wmhunter96/Buka/docs/faces.md

# Face gallery

Every kaomoji face, rendered from the same generator data the firmware uses (each is a 3-second, 30-frame loop). Turn them on with Config / `POST /settings` `{"eyes_style":"kaomoji"}` ([api.md](api.md#kaomoji-eyes)). Faces with no trigger are in the library but not used by any animation yet.

| Face | Preview | Shown for |
| --- | --- | --- |
| Idle | Kaomoji idle | idle (`none`), sleep-open |
| Happy | Kaomoji happy | `welcome`, `talking` |
| Laugh | Kaomoji laugh | not used yet |
| Wink | Kaomoji wink | `print_start` |
| Curious | Kaomoji curious | `attention` |
| Thinking | Kaomoji thinking | `thinking` |
| Reading | Kaomoji reading | `reading`, `typing` |
| Surprise | Kaomoji surprise | `ring` |
| Smug | Kaomoji smug | not used yet |
| Sleepy | Kaomoji sleepy | `wakeup` |
| Sleep | Kaomoji sleep | `sleep`, sleep-close |
| Sad | Kaomoji sad | `dead` |
| Cry | Kaomoji cry | not used yet |
| Angry | Kaomoji angry | `error` |
| Panic | Kaomoji panic | `abort` |
| Shy | Kaomoji shy | not used yet |
| Love | Kaomoji love | not used yet |

Regenerate after editing `scripts/expressions/designs.js`:

```bash
node scripts/expressions/generate.js
node scripts/expressions/render-previews.js
```
