wmhunter96/Buka/mods/desk-plug/3d_models/parts/sg90/step/DeskPlug.step

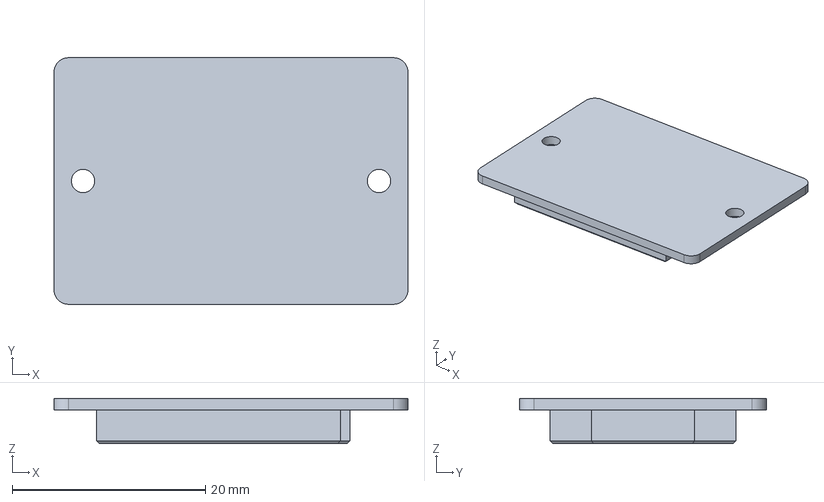
[picture p1: CAD file, 2026-11-02]
mods/desk-plug/3d_models/parts/sg90/step/DeskPlug.step
36.6 x 25.5 x 4.70 mm
