wmhunter96/Buka/mods/plain-emblem/3d_models/parts/sg90/step/AiEmblem-Ring.step

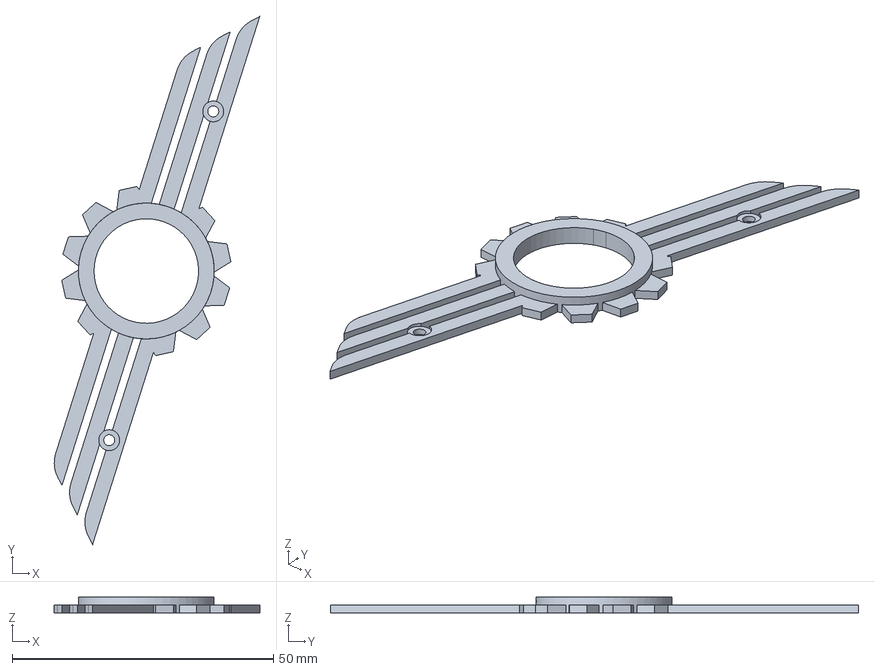
[picture p3: CAD file, 2026-11-01]
mods/plain-emblem/3d_models/parts/sg90/step/AiEmblem-Ring.step
39.3 x 101.1 x 3.00 mm
