wmhunter96/Buka/mods/oled-096/3d_models/parts/sg90/step/Head-096OLED.step

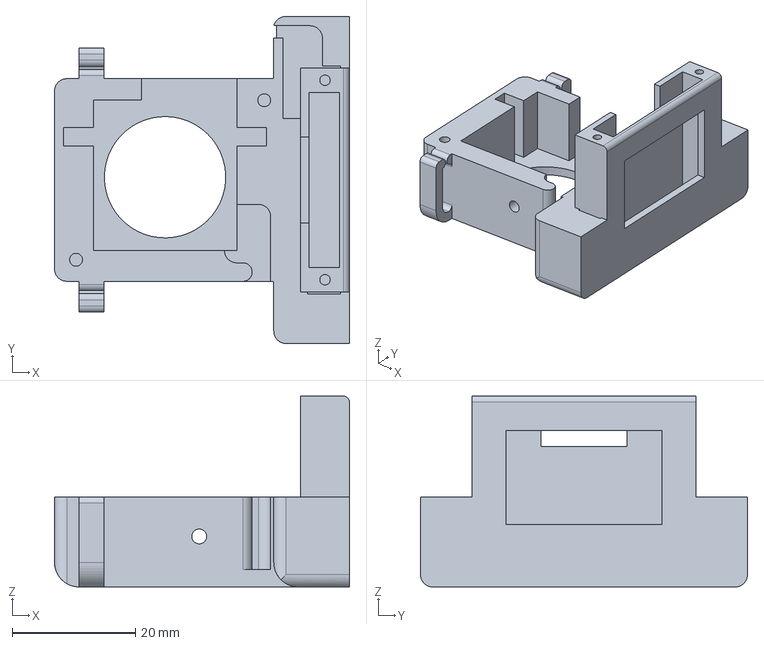
[picture p4: CAD file, 2026-10-31]
mods/oled-096/3d_models/parts/sg90/step/Head-096OLED.step
47.9 x 53.1 x 31.0 mm
