wmhunter96/Buka/mods/oled-096/3d_models/parts/sg90/step/OledCap-096OLED.step

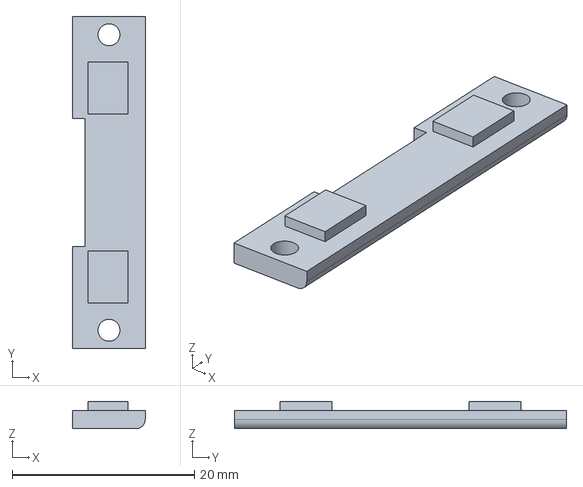
[picture p6: CAD file, 2026-10-31]
mods/oled-096/3d_models/parts/sg90/step/OledCap-096OLED.step
7.95 x 36.4 x 3.00 mm
