wmhunter96/Buka/(list of files, cad)

Other CAD files:
mods/desk-plug/3d_models/parts/sg90/stl/DeskPlug.stl
mods/oled-096/3d_models/parts/sg90/stl/Hat-096OLED.stl
mods/oled-096/3d_models/parts/sg90/stl/Head-096OLED.stl
mods/oled-096/3d_models/parts/sg90/stl/OledCap-096OLED.stl
mods/plain-emblem/3d_models/parts/sg90/stl/AiEmblem-Plain.stl
mods/plain-emblem/3d_models/parts/sg90/stl/AiEmblem-Ring.stl
