wmhunter96/Buka/include/pins.h

#pragma once

#include <cstdint>

// =====================================================
// PINOUT
// =====================================================

#if defined(TE_BOARD_ESP32_DEVKIT)
// Classic ESP32 DevKit (ESP32-WROOM-32, 30/38-pin). GPIO0/2/5/12/15 are
// strapping pins, GPIO1/3 are the USB-serial UART, GPIO6-11 are the flash bus.

// I2C -> PCA9685 + OLED (ESP32 default I2C pins)
constexpr int I2C_SDA = 21;  // D21
constexpr int I2C_SCL = 22;  // D22

// I2S -> MAX98357A
constexpr int I2S_BCLK = 26; // D26
constexpr int I2S_LRC  = 25; // D25
constexpr int I2S_DIN  = 27; // D27

// No addressable RGB LED on a DevKit. GPIO10 is a flash pin here and must
// never be driven, so the RGB status code is compiled out (see rgb.cpp).
constexpr bool RGB_LED_PRESENT = false;
constexpr int RGB_LED_PIN = -1;

#if defined(TE_SERVO_DIRECT)
// Servos driven straight from GPIO (no PCA9685), e.g. on a Goma DevKit
// carrier. Order matches the servo index: HEAD, NECK, HAND_LEFT, HAND_RIGHT,
// BODY (include/servos.h). No strapping pins: avoid D2, D15 (R2, R1).
constexpr int SERVO_DIRECT_PINS[5] = {
  23,  // HEAD       carrier L1
  19,  // NECK       carrier L2
  17,  // HAND_LEFT  carrier L3
  16,  // HAND_RIGHT carrier R3
  18,  // BODY       carrier L4
};
constexpr bool PCA9685_OE_WIRED = false;
#else
// PCA9685 output enable (active LOW). D13 → OE; not a strapping pin.
constexpr bool PCA9685_OE_WIRED = true;
#endif
constexpr int PCA9685_OE_PIN = 13;  // D13

#else  // ESP32-C3-Zero (stock)

// I2C -> PCA9685 + OLED
constexpr int I2C_SDA = 0;   // GP0
constexpr int I2C_SCL = 1;   // GP1

// I2S -> MAX98357A
constexpr int I2S_BCLK = 2;  // GP2
constexpr int I2S_LRC  = 3;  // GP3
constexpr int I2S_DIN  = 4;  // GP4

// Built-in WS2812 RGB
constexpr bool RGB_LED_PRESENT = true;
constexpr int RGB_LED_PIN = 10;

// PCA9685 output enable (active LOW). GP5 → OE; default on.
// Set PCA9685_OE_WIRED false only if OE is hard-tied off-chip (e.g. to GND).
constexpr bool PCA9685_OE_WIRED = true;
constexpr int PCA9685_OE_PIN = 5;

#endif

// =====================================================
// AUDIO
// =====================================================

// assets/ ships 44100 Hz WAVs; scripts/audio_pack.py halves them while packing LittleFS.
constexpr int SAMPLE_RATE = 22050;

// =====================================================
// PCA9685 / SERVOS
// =====================================================

constexpr uint8_t PCA9685_ADDRESS = 0x40;

constexpr int SERVO_STEP_MS = 10;

// Boot centering / sleep-pose rate (deg/s)
constexpr float SERVO_BOOT_SPEED_DEG_S = 35.0f;

// Servo pulse range
constexpr int SERVO_MIN_US = 800;
constexpr int SERVO_MAX_US = 2200;

// =====================================================
// OLED
// =====================================================

// OLED_WIDTH x OLED_HEIGHT is the drawing frame every face and screen uses.
constexpr int OLED_WIDTH  = 128;
constexpr int OLED_HEIGHT = 32;
constexpr uint8_t OLED_ADDRESS = 0x3C;

// Physical panel rows. TE_OLED_128X64: 0.96" SSD1306 128x64 module; the 128x32
// frame is centered on it (see src/display/oled_internal.h).
#if defined(TE_OLED_128X64)
constexpr int OLED_PANEL_HEIGHT = 64;
#else
constexpr int OLED_PANEL_HEIGHT = 32;  // stock Waveshare 0.91" 128x32
#endif
