wmhunter96/Buka/src/animation/registry.cpp

#include "animation/registry.h"

#include <Arduino.h>
#include <cstddef>
#include <cstring>

#include "animation/abort.h"
#include "animation/attention.h"
#include "animation/dead.h"
#include "animation/error.h"
#include "animation/print_start.h"
#include "animation/reading.h"
#include "animation/ring.h"
#include "animation/sleep_anim.h"
#include "animation/talking.h"
#include "animation/thinking.h"
#include "animation/typing.h"
#include "animation/util.h"
#include "animation/wakeup.h"
#include "animation/welcome.h"
#include "display/eyes/modes/abort.h"
#include "display/eyes/modes/attention.h"
#include "display/eyes/modes/dead.h"
#include "display/eyes/modes/error.h"
#include "display/eyes/modes/idle.h"
#include "display/eyes/modes/print_start.h"
#include "display/eyes/modes/reading.h"
#include "display/eyes/modes/ring.h"
#include "display/eyes/modes/talking.h"
#include "display/eyes/modes/thinking.h"
#include "display/eyes/modes/typing.h"
#include "display/eyes/modes/wakeup.h"
#include "display/eyes/modes/welcome.h"
#include "hardware/servo_wrapper.h"
#include "network/wifi_connect.h"
#include "sleep.h"

namespace {

uint32_t g_noneStillSinceMs = 0;
bool g_noneStillTracking = false;

void startNoneAt(uint32_t /*nowMs*/) {
  g_noneStillTracking = false;
  g_noneStillSinceMs = 0;
  anim::stopAnimServos();
  // Sleeping: keep chin-down (same pose wakeup starts from).
  if (isSleeping()) {
    anim::parkSleepPose();
    return;
  }

  anim::parkNonePose();
}

void updateNoneAt(uint32_t nowMs) {
  updateAllServos();

  if (wifiProvisioningMode()) {
    g_noneStillTracking = false;
    return;
  }

  if (anyServoMoving()) {
    g_noneStillTracking = false;
    return;
  }

  if (!g_noneStillTracking) {
    g_noneStillTracking = true;
    g_noneStillSinceMs = nowMs;
    return;
  }

  if (nowMs - g_noneStillSinceMs >= SERVO_PWM_RELEASE_DELAY_MS) {
    releaseAllServoOutputs();
  }
}

void startTypingAt(uint32_t /*nowMs*/) {
  startTyping();
}

void startReadingAt(uint32_t /*nowMs*/) {
  startReading();
}

void startTalkingAt(uint32_t /*nowMs*/) {
  startTalking();
}

void startRingAt(uint32_t /*nowMs*/) {
  startRing();
}

void startWelcomeAt(uint32_t /*nowMs*/) {
  startWelcome();
}

void startAttentionAt(uint32_t /*nowMs*/) {
  startAttention();
}

void startErrorAt(uint32_t /*nowMs*/) {
  startError();
}

void startAbortAt(uint32_t /*nowMs*/) {
  startAbort();
}

void startPrintStartAt(uint32_t /*nowMs*/) {
  startPrintStart();
}

void startWakeupAt(uint32_t nowMs) {
  startWakeup(nowMs, true);
}

void updateWakeupAt(uint32_t nowMs) {
  if (wakeupFinished()) {
    return;
  }

  updateWakeup(nowMs);

  if (wakeupFinished()) {
    finishAnimation(nowMs);
  }
}

void startSleepAt(uint32_t nowMs) {
  startSleepAnim(nowMs);
}

void startDeadAt(uint32_t /*nowMs*/) {
  startDead();
}

constexpr ModeEntry kModes[] = {
  {
    AnimationId::None,
    EyeMode::Idle,
    "none",
    false,
    -1,
    startNoneAt,
    updateNoneAt,
    startIdleEyes,
    updateIdleEyes,
  },
  {
    AnimationId::Typing,
    EyeMode::Typing,
    "typing",
    true,
    -1,
    startTypingAt,
    updateTyping,
    startTypingEyes,
    updateTypingEyes,
  },
  {
    AnimationId::Reading,
    EyeMode::Reading,
    "reading",
    true,
    -1,
    startReadingAt,
    updateReading,
    startReadingEyes,
    updateReadingEyes,
  },
  {
    AnimationId::Thinking,
    EyeMode::Thinking,
    "thinking",
    true,
    -1,
    startThinking,
    updateThinking,
    startThinkingEyes,
    updateThinkingEyes,
  },
  {
    AnimationId::Ring,
    EyeMode::Ring,
    "ring",
    false,
    -1,
    startRingAt,
    updateRing,
    startRingEyes,
    updateRingEyes,
  },
  {
    AnimationId::Welcome,
    EyeMode::Welcome,
    "welcome",
    false,
    10000,
    startWelcomeAt,
    updateWelcome,
    startWelcomeEyes,
    updateWelcomeEyes,
  },
  {
    AnimationId::Attention,
    EyeMode::Attention,
    "attention",
    false,
    1200,
    startAttentionAt,
    updateAttention,
    startAttentionEyes,
    updateAttentionEyes,
  },
  {
    AnimationId::Error,
    EyeMode::Error,
    "error",
    false,
    2300,
    startErrorAt,
    updateError,
    startErrorEyes,
    updateErrorEyes,
  },
  {
    AnimationId::Abort,
    EyeMode::Abort,
    "abort",
    false,
    1500,
    startAbortAt,
    updateAbort,
    startAbortEyes,
    updateAbortEyes,
  },
  {
    AnimationId::Wakeup,
    EyeMode::Wakeup,
    "wakeup",
    false,
    -1,
    startWakeupAt,
    updateWakeupAt,
    startWakeupEyes,
    updateWakeupEyes,
  },
  {
    AnimationId::Sleep,
    EyeMode::Idle,
    "sleep",
    false,
    -1,
    startSleepAt,
    updateSleepAnim,
    startIdleEyes,
    updateIdleEyes,
  },
  {
    AnimationId::Dead,
    EyeMode::Dead,
    "dead",
    false,
    -1,
    startDeadAt,
    updateDead,
    startDeadEyes,
    updateDeadEyes,
  },
  {
    AnimationId::Talking,
    EyeMode::Talking,
    "talking",
    true,
    -1,
    startTalkingAt,
    updateTalking,
    startTalkingEyes,
    updateTalkingEyes,
  },
  {
    AnimationId::PrintStart,
    EyeMode::PrintStart,
    "print_start",
    false,
    -1,
    startPrintStartAt,
    updatePrintStart,
    startPrintStartEyes,
    updatePrintStartEyes,
  },
};

constexpr size_t kModeCount = sizeof(kModes) / sizeof(kModes[0]);

}  // namespace

const ModeEntry* modeByAnimId(AnimationId id) {
  for (size_t i = 0; i < kModeCount; i++) {
    if (kModes[i].animId == id) {
      return &kModes[i];
    }
  }

  return &kModes[0];
}

const ModeEntry* modeByEyeMode(EyeMode mode) {
  for (size_t i = 0; i < kModeCount; i++) {
    if (kModes[i].eyeMode == mode) {
      return &kModes[i];
    }
  }

  return &kModes[0];
}

const ModeEntry* modeByName(const char* name) {
  if (name == nullptr) {
    return nullptr;
  }

  for (size_t i = 0; i < kModeCount; i++) {
    if (strcmp(kModes[i].name, name) == 0) {
      return &kModes[i];
    }
  }

  return nullptr;
}
