wmhunter96/Buka/(commit log)

2026-10-31 feat(firmware): add classic ESP32 DevKit build env
    Claude-Session: https://claude.ai/code/session_01JLP55RC5H1vzSJ5vzMbmAE
2026-10-31 feat(firmware): support 0.96in 128x64 OLED on the ESP32 DevKit build
    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
2026-10-31 feat(mods): add 0.96in OLED head
    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
    [Hat-096OLED.step, Hat-096OLED.stl, Head-096OLED.step, Head-096OLED.stl, OledCap-096OLED.step, OledCap-096OLED.stl]
2026-11-01 feat(mods): add plain emblem without AI letters
    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
    [AiEmblem-Plain.step, AiEmblem-Plain.stl, AiEmblem-Ring.step, AiEmblem-Ring.stl]
2026-11-01 feat(servos): drive servos from GPIO on a Goma DevKit carrier (buka env)
    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
2026-11-02 feat(http): add POST /usage to show Claude usage limits on the OLED
    On a 128x64 panel (TE_OLED_128X64) the 5-hour window is drawn as a bar in
    the spare rows above the face and the 7-day window below it. TeDisplay
    redraws the strips on every display() call, so faces are untouched. Values
    live in RAM and each window hides itself when its resets_in runs out (the
    firmware has no wall clock). The stock 128x32 build accepts the route but
    draws nothing.
    [handlers.h, routes.cpp, usage_handlers.cpp]
2026-11-02 feat(integrations): add tiny-engineer statusline for Claude usage limits
    Claude Code statusLine command: reads rate_limits, prints the model and
    both windows with reset countdowns, and POSTs /usage when a rounded
    percentage changes (or every 5 minutes). HTTP only, 1.5 s timeout,
    fail-open so an offline robot never delays the status line.
2026-11-02 feat(firmware): enable Wi-Fi updates on the buka env
    Switch buka to partitions_ota.csv and TE_OTA with scripts/ota.py, so after
    one USB flash the robot updates with pio run -e buka -t ota / -t otafs.
    Firmware uses 84% of a 1.5 MB slot; assets fit the 960 KB LittleFS.
2026-11-02 feat(mods): add desk plug for the lamp opening
    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
    [DeskPlug.step, DeskPlug.stl]
2026-11-02 feat(firmware): add gundam eyes style
    Mobile-suit face for eyes_style=gundam: fixed V-fin, forehead crest, cheek
    lines, mouth vents and chin in the 128x32 frame, with angular slit eyes that
    follow the classic pose so blinks, glances and sleep still read.
    [registry.cpp, test_settings_validate.cpp]
2026-11-02 feat(firmware): show a happy face with a progress bar during OTA
    Replace the "OTA UPDATE" text screen with closed ^ ^ eyes, a smile and a
    progress bar, and wake the panel if the sleep timer switched it off.
    Failures still show "OTA FAILED".
2026-11-02 feat(integrations): share the robot across concurrent Claude Code sessions
    Hooks now track sessions by session_id in a temp-dir state file. While
    another session is working, a finishing session rings and then hands the
    pose back, a closing session no longer puts the robot to sleep, and
    welcome/error/abort play and hand back. A newer event always owns the pose
    and sessions silent for 10 minutes are dropped. Integrations opt in through
    an optional arbitrate() hook; Cursor and Antigravity are unchanged.
2026-11-02 feat(firmware)!: animated 16-face gundam set; remove dots and cover styles
    eyes_style=gundam now plays a 16-expression mobile-suit face set (fixed
    helmet: V-fin, crest, cheek lines, mouth vents, chin; eyes and side symbols
    carry the mood) with the same mood mapping as kaomoji, replacing the single
    procedural face. The expression library gains FaceSet { Kaomoji, Gundam };
    render(Expression, ...) still renders kaomoji. The generator builds both
    sets; kaomoji assets are byte-identical, gundam adds ~41 KB (114 unique
    frames). --check now ignores CRLF line endings.
    BREAKING CHANGE: eyes_style no longer accepts "dots" or "cover"; a saved
    value falls back to "classic" on boot.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
    [registry.cpp, test_settings_validate.cpp]
2026-11-02 docs(docs): add an animated face gallery for the kaomoji and gundam sets
    scripts/expressions/render-previews.js renders every expression of every
    set as a looping APNG straight from the generator's frames, so the gallery
    matches the firmware pixel for pixel. docs/faces.md shows both sets side by
    side with the animation that triggers each face.
2026-11-02 fix(firmware): drop the V-fin, crest and cheek lines from the gundam faces
    The fin belongs on the printed head, not the screen. The faces are now the
    stern slit eyes over the stacked-chevron vent, moved up to center in the
    32 rows; the cheek lines and chin that boxed the vent in are gone. The set
    shrinks from ~40 KB to ~23 KB. Gallery previews re-rendered.
2026-11-02 feat(anim): add print_start one-shot animation
    Fist pump for a 3D print starting: right hand and head up, a hold, a nod,
    then back to the none pose (~2.9 s, no audio). Classic eyes wink; kaomoji
    and gundam show the Wink face. POST /anim, the web UI and the API page list
    the new name.
2026-11-02 feat(integrations): add tiny-engineer prusalink printer watcher
    Polls a Prusa printer's PrusaLink API (GET /api/v1/status, HTTP Digest or
    X-Api-Key) and plays print_start when a print starts and ring when it
    finishes; nothing while printing. A print already running at startup is
    not a start. Printer events join the shared session state, so a working
    Claude Code session gets its pose back after the one-shot.
2026-11-02 feat(firmware)!: remove the gundam style; smaller kaomoji eyes
    Drop the gundam face set (designs, assets, FaceSet API) and restore the
    single-set expression library. The kaomoji eye is now a short, wide 14x9
    rounded rectangle instead of 18x16, with Thinking and Angry scaled to
    match; golden hashes updated for Idle, Wink, Thinking and Angry. The face
    gallery shows the kaomoji set only.
    BREAKING CHANGE: eyes_style no longer accepts "gundam"; a saved value falls
    back to "classic" on boot.
    [registry.cpp, test_settings_validate.cpp]
2026-11-02 feat(anim): bigger arm moves, smaller body moves
    Body poses scale with a calibrated range ~3-4x wider than the hands, so the
    body dominated. Arms now use more of their range: typing band doubled (also
    lifts talking), bigger attention, error and abort hand poses, print_start
    hand to full height. Body toned down: ring wind-up 35% toward min instead of
    full, typing/talking/error/abort sways halved. All poses stay inside the
    calibrated ranges.
    [constants.h, print_start.cpp]
2026-11-02 feat(firmware): sleepy kaomoji face in the last stretch before idle sleep
    isDrowsy() is true for the final 2 minutes of the sleep_timeout countdown
    (or its second half, if shorter); the kaomoji style shows its Sleepy face
    then, so the robot visibly nods off before the OLED blanks. With
    sleep_timeout 5 that is minutes 3-5 of idle.
    [sleep.cpp, sleep.h]
